leo60228/fusb301-breakout/fusb302/fusb301-breakout.kicad_pcb

## KiCad design fusb302/fusb301-breakout.kicad_pcb (2021-07-03)

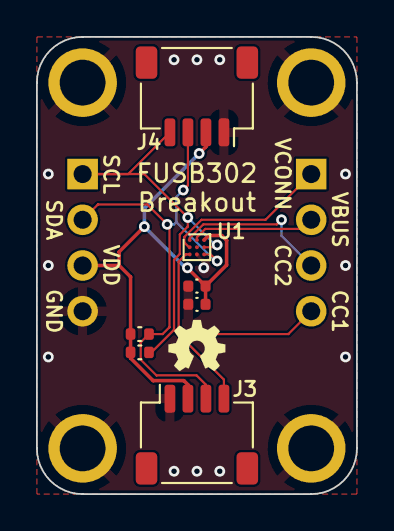
[picture p1: board fusb302/fusb301-breakout.kicad_pcb from above]

Board: 2 copper layers, 17.8 x 25.4 mm, 13 parts (0 on the bottom side), 8 nets.

Parts:
C1: 0.1uF; C_0402_1005Metric
C2: 10uF; C_0402_1005Metric
H1, H2, H3, H4: MountingHole_2.5mm_Pad
J1, J2: Conn_01x04_Male; PinHeader_1x04_P2.54mm_Vertical
J3, J4: Conn_01x04_Male; JST_SH_SM04B-SRSS-TB_1x04-1MP_P1.00mm_Horizontal
R1, R2: 10K; R_0402_1005Metric
U1: FUSB302BUCX; WLCSP-9_1.260x1.215mm_P0.4mm

Connections:
/CC1: J2.4, U1.C1 (CC1)
/CC2: J2.3, U1.A1 (CC2)
/SCL: J1.1, J3.4, J4.4, R2.2, U1.B3 (SCL)
/SDA: J1.2, J3.3, J4.3, R1.2, U1.C3 (SDA)
/VBUS: J2.2, U1.A2 (VBUS)
/VCONN: J2.1, U1.B1 (VCONN)
GND: C1.2, C2.2, H1.1, H2.1, H3.1, H4.1, J1.4, J3.1, J4.1, U1.C2 (GND)
VDD: C1.1, C2.1, J1.3, J3.2, J4.2, R1.1, R2.1, U1.A3 (VDD)
