leo60228/fusb301-breakout/usb/fusb301-breakout.kicad_pcb

## KiCad design usb/fusb301-breakout.kicad_pcb (2021-07-03)

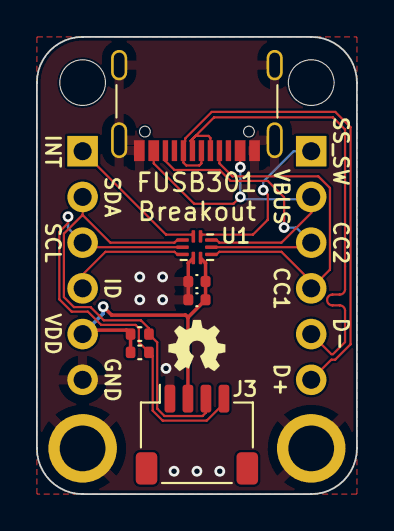
[picture p2: board usb/fusb301-breakout.kicad_pcb from above]

Board: 2 copper layers, 17.8 x 25.4 mm, 13 parts (0 on the bottom side), 12 nets.

Parts:
C1: 0.1uF; C_0402_1005Metric
C2: 10uF; C_0402_1005Metric
H1, H2: MountingHole_2.5mm
H3, H4: MountingHole_2.5mm_Pad
J1, J2: Conn_01x06_Male; PinHeader_1x06_P2.54mm_Vertical
J3: Conn_01x04_Male; JST_SH_SM04B-SRSS-TB_1x04-1MP_P1.00mm_Horizontal
J4: USB_C_Receptacle_USB2.0; USB_C_Receptacle_Palconn_UTC16-G
R1, R2: 10K; R_0402_1005Metric
U1: FUSB301; OnSemi_X2QFN-10_1.6x1.2mm_P0.4mm

Connections:
/CC1: J2.4, J4.A5 (CC1), U1.6 (CC1)
/CC2: J2.3, J4.B5 (CC2), U1.7 (CC2)
/D+: J2.6, J4.A6 (D+), J4.B6 (D+)
/D-: J2.5, J4.A7 (D-), J4.B7 (D-)
/ID: J1.4, U1.3 (ID)
/INT_N: J1.1, U1.10 (INT_N)
/SCL: J1.3, J3.4, R2.2, U1.2 (SCL)
/SDA: J1.2, J3.3, R1.2, U1.1 (SDA)
/SS_SW: J2.1, U1.9 (SS_SW)
/VBUS: J2.2, J4.A4 (VBUS), J4.A9 (VBUS), J4.B4 (VBUS), J4.B9 (VBUS), U1.8 (VBUS)
GND: C1.2, C2.2, H3.1, H4.1, J1.6, J3.1, J4.A1 (GND), J4.A12 (GND), J4.B1 (GND), J4.B12 (GND), J4.S1 (SHIELD), U1.4 (GND)
VDD: C1.1, C2.1, J1.5, J3.2, R1.1, R2.1, U1.5 (VDD)
