leo60228/fusb301-breakout/usb-c-intercept.kicad_pcb

## KiCad design usb-c-intercept.kicad_pcb (2021-07-03)

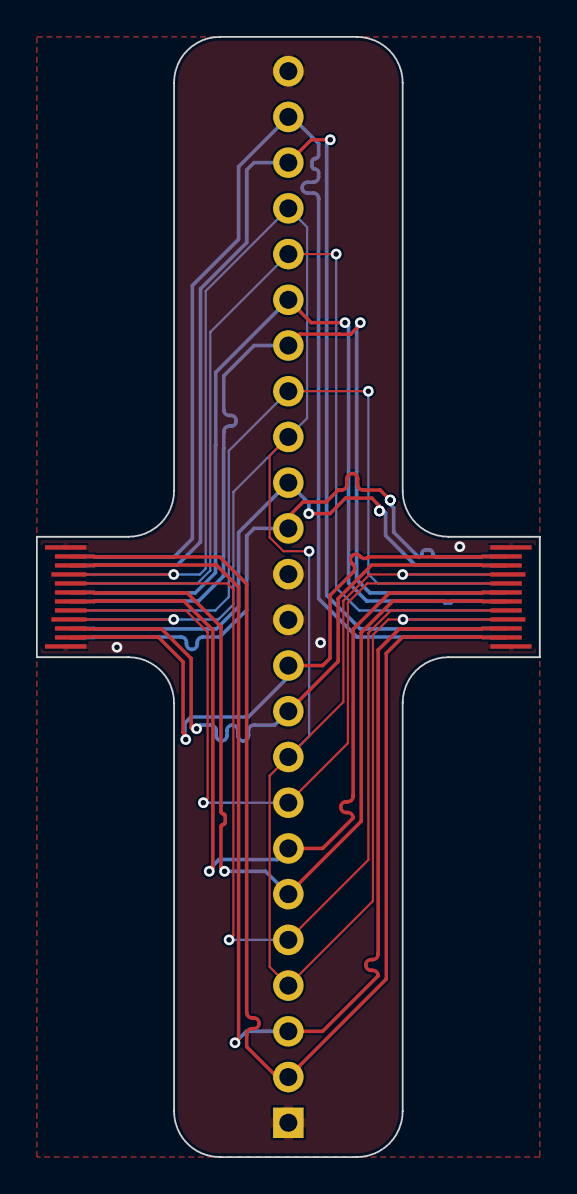
[picture p3: board usb-c-intercept.kicad_pcb from above]

Board: 2 copper layers, 27.9 x 62.2 mm, 3 parts (0 on the bottom side), 18 nets.

Parts:
J1, J2: USB_C_Receptacle; USB_C_Receptable_PCB
J3: Conn_01x24_Male; PinHeader_1x24_P2.54mm_Vertical

Connections:
/A3_A2_TX1+: J1.A2 (TX1+), J2.A2 (TX1+), J3.2
/A3_A2_TX1-: J1.A3 (TX1-), J2.A3 (TX1-), J3.3
/A5_CC1: J1.A5 (CC1), J2.A5 (CC1), J3.5
/A7_A6_D+: J1.A6 (D+), J2.A6 (D+), J3.6
/A7_A6_D-: J1.A7 (D-), J2.A7 (D-), J3.7
/A8_SBU1: J1.A8 (SBU1), J2.A8 (SBU1), J3.8
/A10_A11_RX2+: J1.A11 (RX2+), J2.A11 (RX2+), J3.11
/A10_A11_RX2-: J1.A10 (RX2-), J2.A10 (RX2-), J3.10
/B3_B2_TX2+: J1.B2 (TX2+), J2.B2 (TX2+), J3.14
/B3_B2_TX2-: J1.B3 (TX2-), J2.B3 (TX2-), J3.15
/B5_CC2: J1.B5 (CC2), J2.B5 (CC2), J3.17
/B7_B6_D+: J1.B6 (D+), J2.B6 (D+), J3.18
/B7_B6_D-: J1.B7 (D-), J2.B7 (D-), J3.19
/B8_SBU2: J1.B8 (SBU2), J2.B8 (SBU2), J3.20
/B10_B11_RX1+: J1.B11 (RX1+), J2.B11 (RX1+), J3.23
/B10_B11_RX1-: J1.B10 (RX1-), J2.B10 (RX1-), J3.22
GND: J1.A1 (GND), J1.A12 (GND), J1.B1 (GND), J1.B12 (GND), J2.A1 (GND), J2.A12 (GND), J2.B1 (GND), J2.B12 (GND), J3.1, J3.12, J3.13, J3.24
VBUS: J1.A4 (VBUS), J1.A9 (VBUS), J1.B4 (VBUS), J1.B9 (VBUS), J2.A4 (VBUS), J2.A9 (VBUS), J2.B4 (VBUS), J2.B9 (VBUS), J3.4, J3.9, J3.16, J3.21
