leo60228/fusb301-breakout/fusb301-breakout.kicad_pcb

## KiCad design fusb301-breakout.kicad_pcb (2021-07-03)

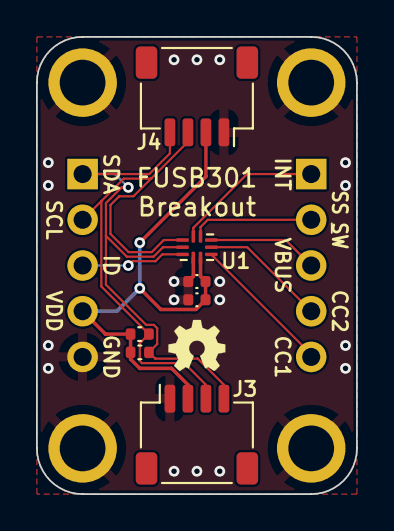
[picture p4: board fusb301-breakout.kicad_pcb from above]

Board: 2 copper layers, 17.8 x 25.4 mm, 13 parts (0 on the bottom side), 10 nets.

Parts:
C1: 0.1uF; C_0402_1005Metric
C2: 10uF; C_0402_1005Metric
H1, H2, H3, H4: MountingHole_2.5mm_Pad
J1, J2: Conn_01x05_Male; PinHeader_1x05_P2.54mm_Vertical
J3, J4: Conn_01x04_Male; JST_SH_SM04B-SRSS-TB_1x04-1MP_P1.00mm_Horizontal
R1, R2: 10K; R_0402_1005Metric
U1: FUSB301; OnSemi_X2QFN-10_1.6x1.2mm_P0.4mm

Connections:
/CC1: J2.5, U1.6 (CC1)
/CC2: J2.4, U1.7 (CC2)
/ID: J1.3, U1.3 (ID)
/SCL: J1.1, J3.4, J4.4, R2.2, U1.2 (SCL)
/SDA: J1.2, J3.3, J4.3, R1.2, U1.1 (SDA)
/SS_SW: J2.2, U1.9 (SS_SW)
/VBUS: J2.3, U1.8 (VBUS)
/~INT: J2.1, U1.10 (~INT)
GND: C1.2, C2.2, H1.1, H2.1, H3.1, H4.1, J1.5, J3.1, J4.1, U1.4 (GND)
VDD: C1.1, C2.1, J1.4, J3.2, J4.2, R1.1, R2.1, U1.5 (VDD)
